gaetanars/esphome-portail/hardware/portail-pcb/portail-pcb.kicad_pcb

## KiCad design hardware/portail-pcb/portail-pcb.kicad_pcb (2026-11-11)

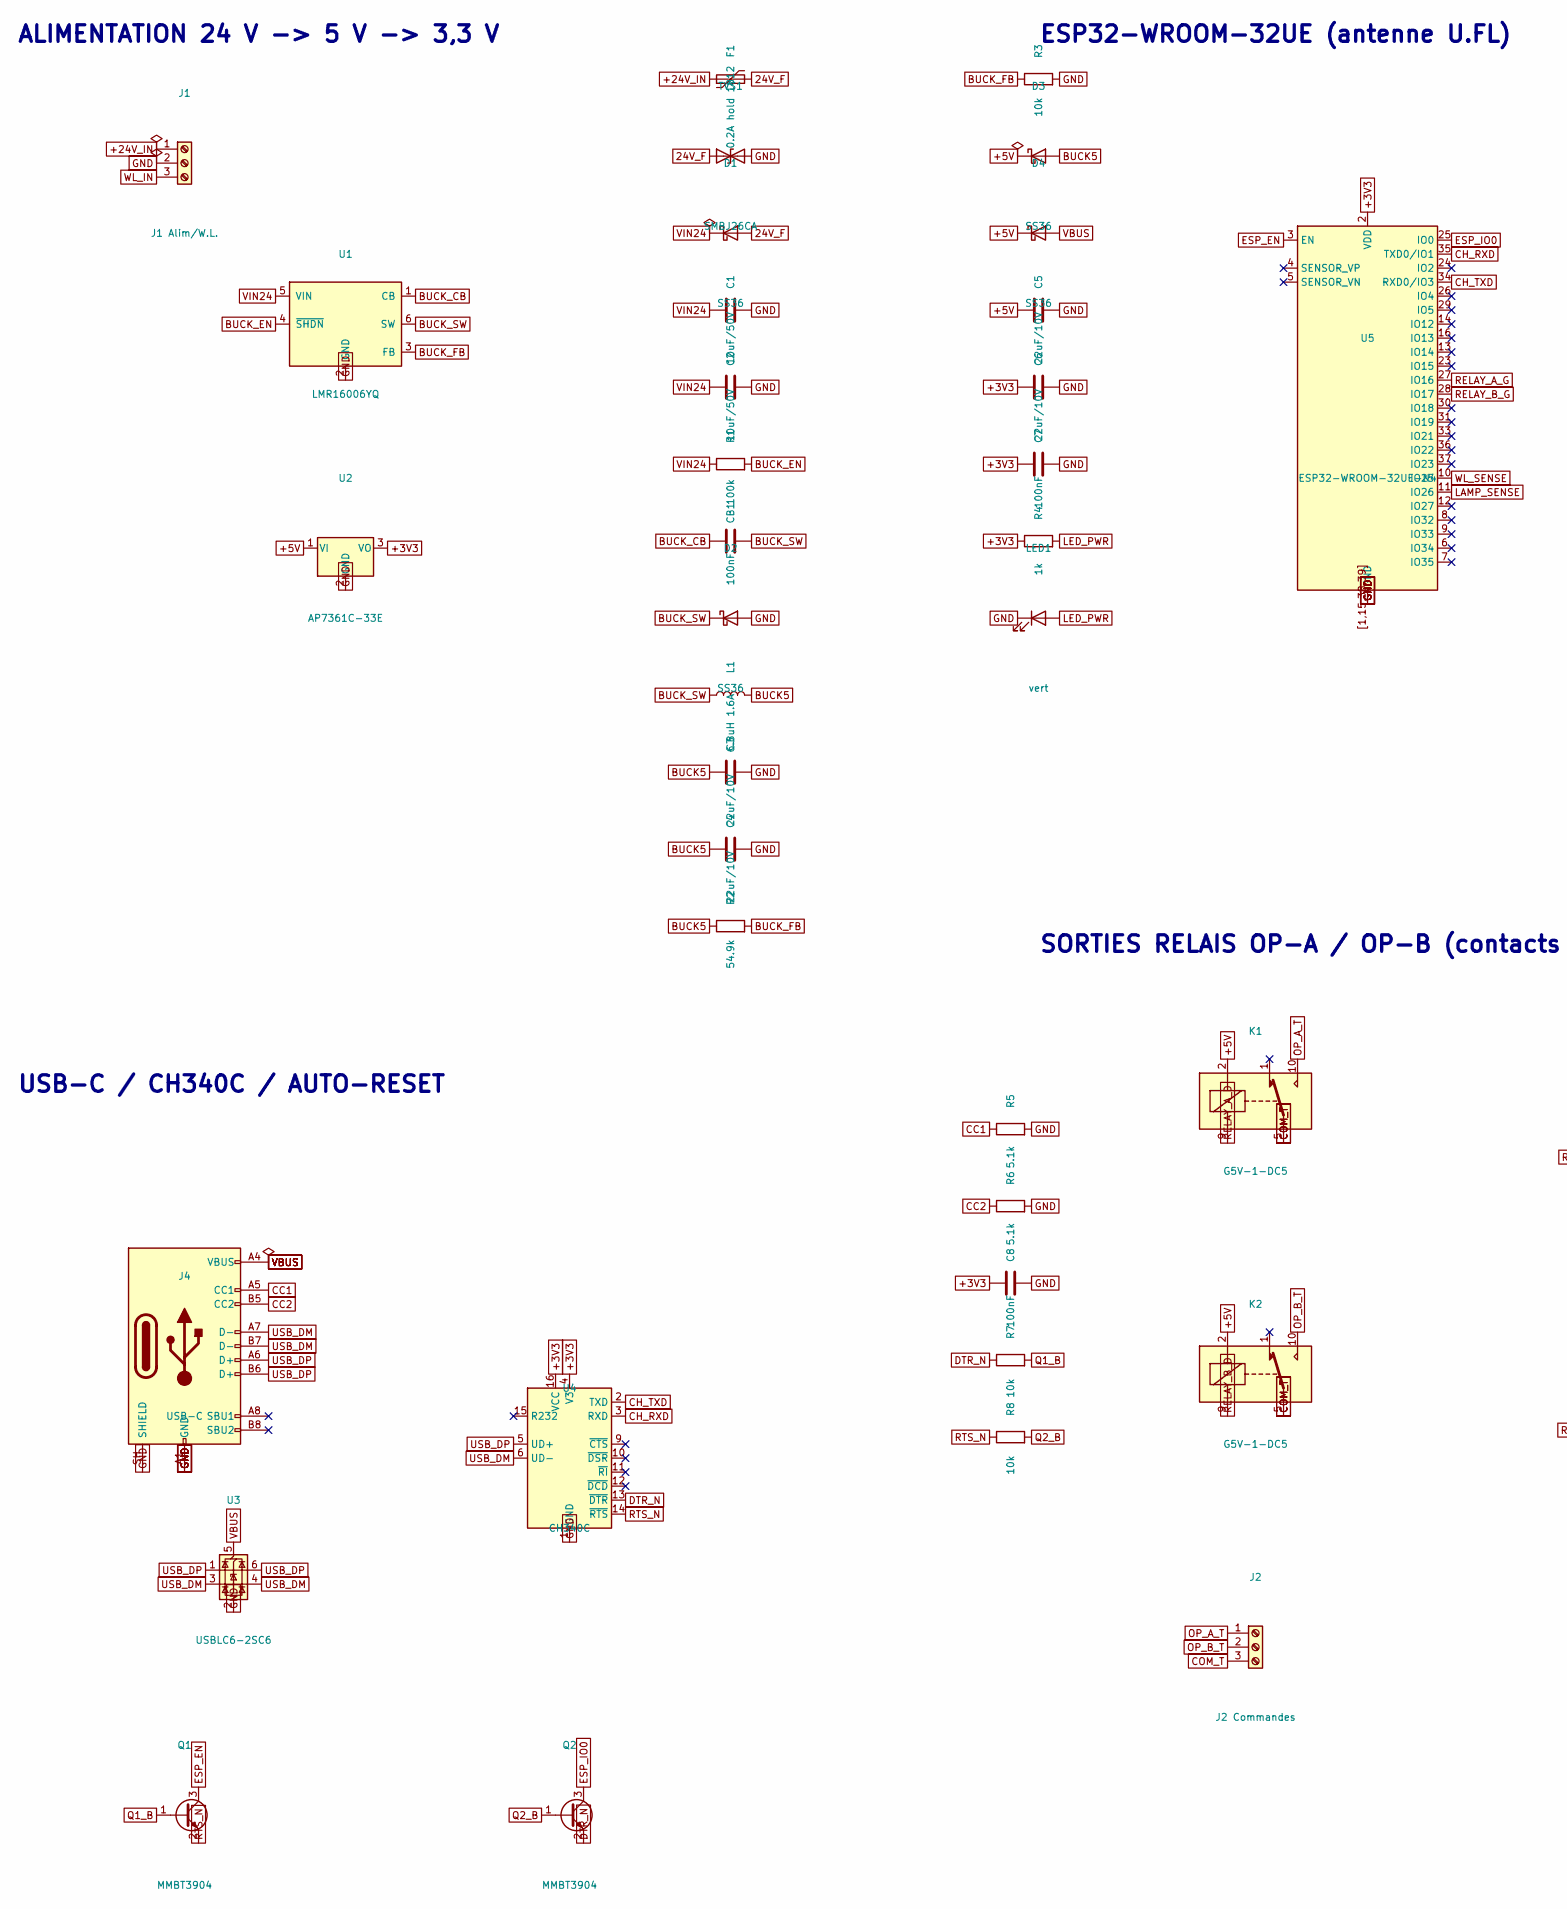
[picture p1: schematic portail-pcb.kicad_sch, Portail FAAC E045S - carte ESP32, part in row 1, column 1]

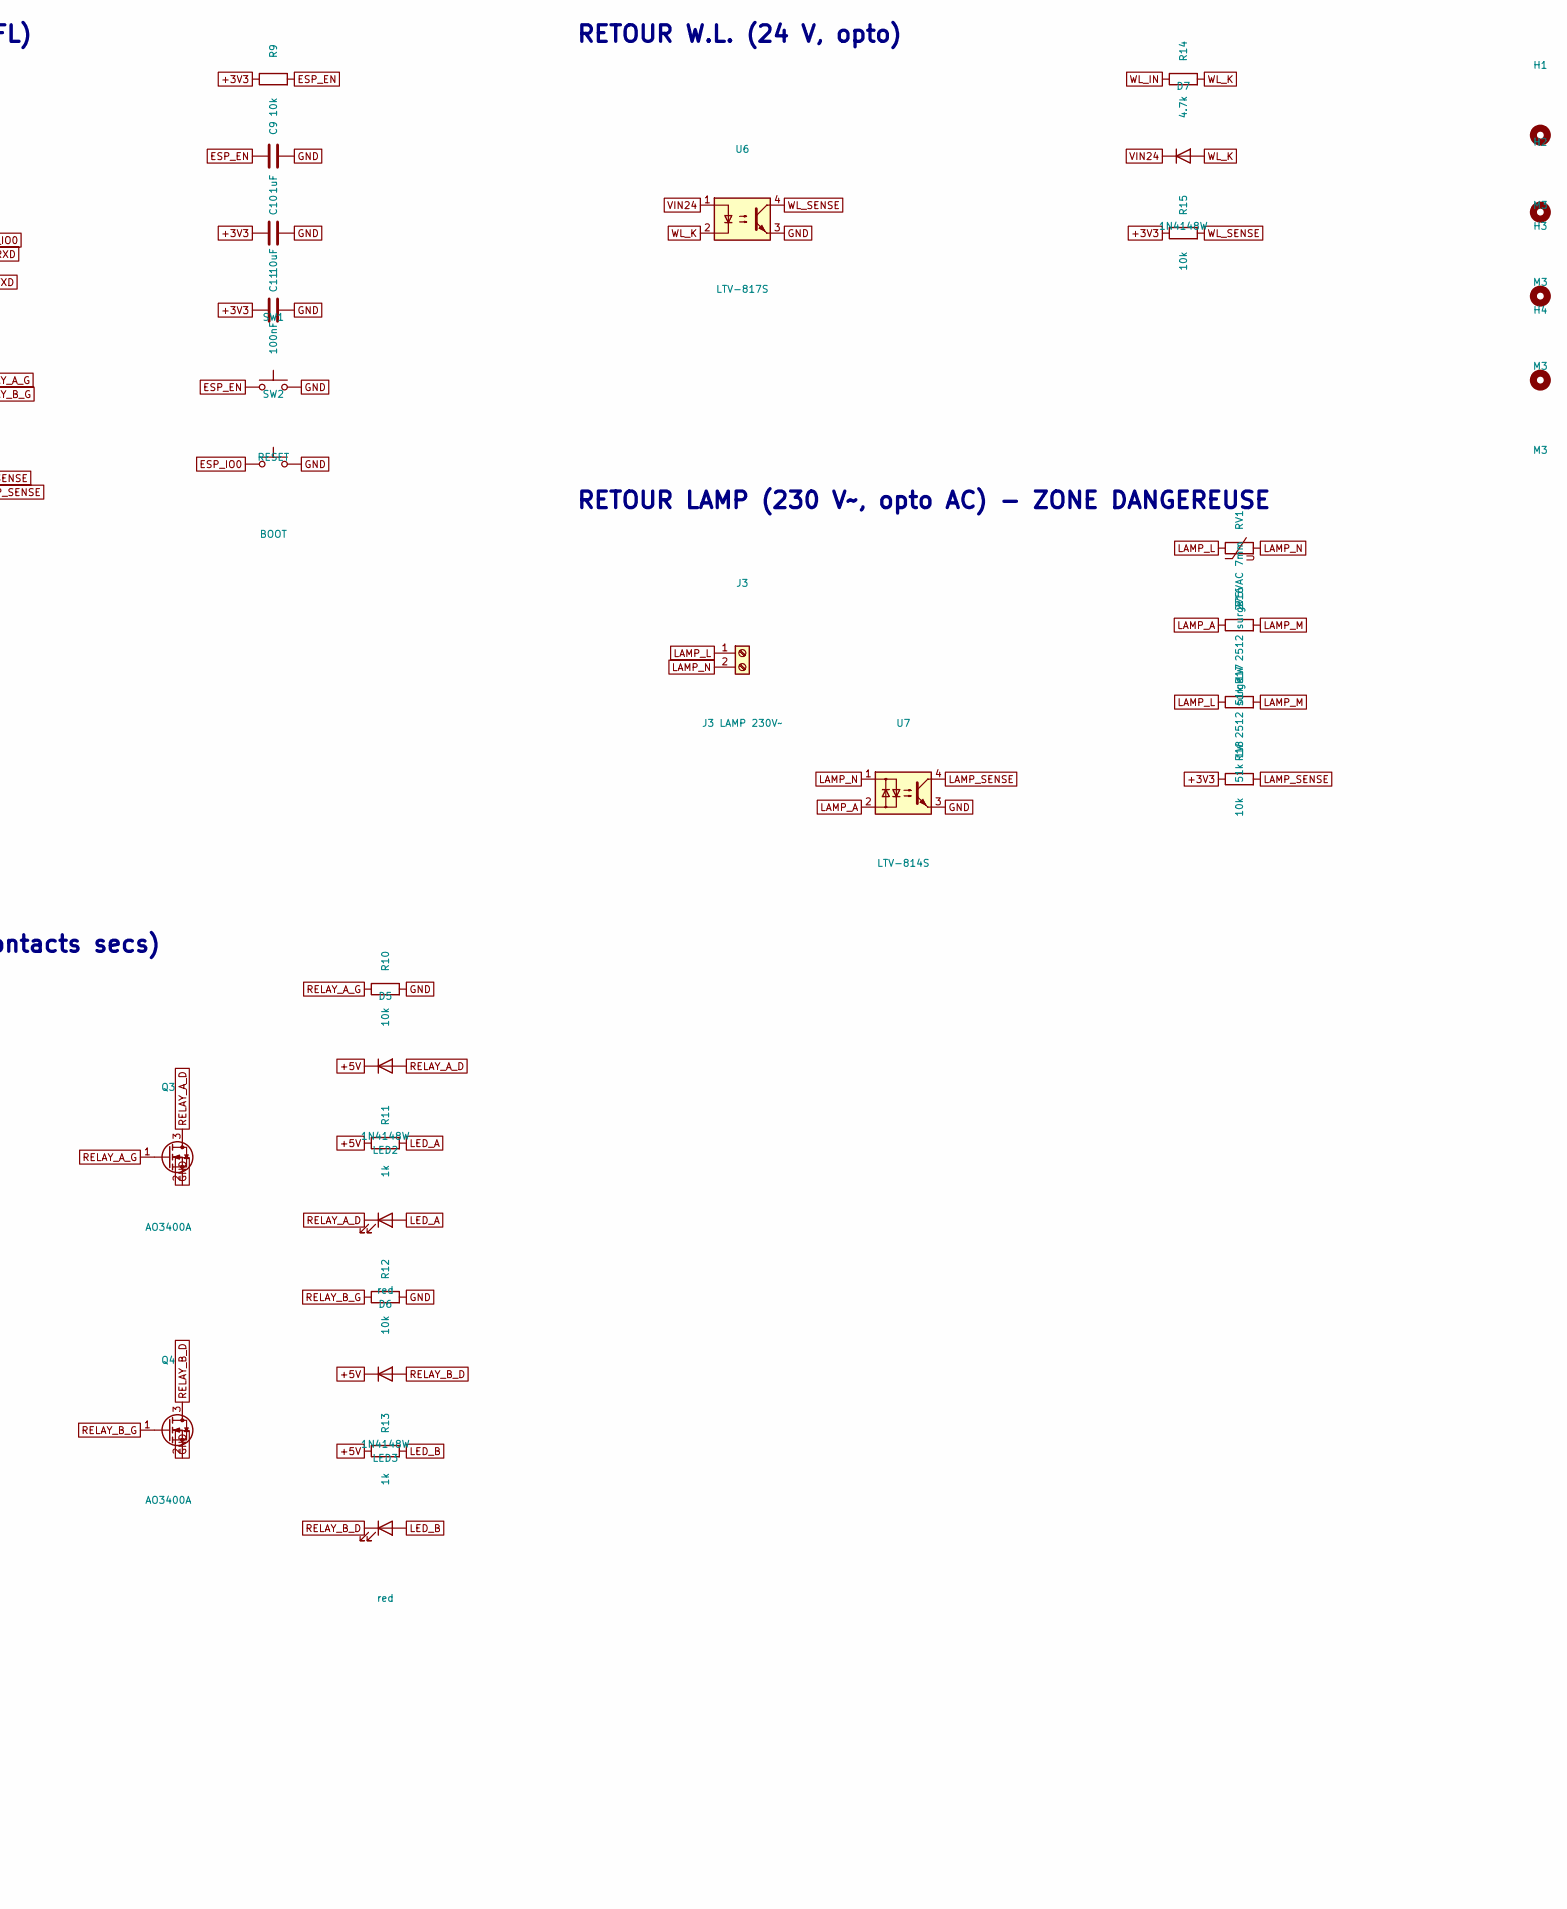
[picture p2: schematic portail-pcb.kicad_sch, Portail FAAC E045S - carte ESP32, part in row 1, column 2]

Parts:
C1, C2: 10uF/50V; C_1210_3225Metric; MPN GRM32ER71H106KA12L
C3, C4, C5, C6: 22uF/10V; C_0805_2012Metric; MPN CL21A226MPQNNNE
C7, C8, C11: 100nF; C_0603_1608Metric; MPN CC0603KRX7R9BB104
C9: 1uF; C_0603_1608Metric; MPN CL10B105KA8NNNC
C10: 10uF; C_0805_2012Metric; MPN CL21A106KAYNNNE
CB1: 100nF; C_0603_1608Metric; MPN CC0603KRX7R9BB104
D1, D2, D3, D4: SS36; D_SMA; MPN SS36
D5, D6, D7: 1N4148W; D_SOD-123; MPN 1N4148W-7-F
F1: 0.2A hold 1812; Fuse_1812_4532Metric; MPN MF-MSMF020/60-2
H1, H2, H3, H4: M3; MountingHole_3.2mm_M3
J1: J1 Alim/W.L.; TerminalBlock_Phoenix_MKDS-1,5-3-5.08_1x03_P5.08mm_Horizont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; MPN DG500-5.08-03P-14-00A(H)
J2: J2 Commandes; TerminalBlock_Phoenix_MKDS-1,5-3-5.08_1x03_P5.08mm_Horizont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; MPN DG500-5.08-03P-14-00A(H)
J3: J3 LAMP 230V~; TerminalBlock_Phoenix_MKDS-1,5-2-5.08_1x02_P5.08mm_Horizont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; MPN DG500-5.08-02P-14-00A(H)
J4: USB-C; USB_C_Receptacle_HRO_TYPE-C-31-M-12; MPN TYPE-C-31-M-12
K1, K2: G5V-1-DC5; Relay_SPDT_Omron_G5V-1; MPN G5V-1-DC5
L1: 6.8uH 1.6A; L_Bourns_SRN6045TA; MPN SRN6045TA-6R8M
LED1: vert; LED_0603_1608Metric; MPN KT-0603G
LED2, LED3: red; LED_0603_1608Metric; MPN KT-0603R
Q1, Q2: MMBT3904; SOT-23; MPN MMBT3904LT1G
Q3, Q4: AO3400A; SOT-23; MPN AO3400A
R1: 100k; R_0603_1608Metric; MPN RC0603FR-07100KL
R2: 54.9k; R_0603_1608Metric; MPN RC0603FR-0754K9L
R3, R7, R8, R9, R10, R12, R15, R18: 10k; R_0603_1608Metric; MPN RC0603FR-0710KL
R4, R11, R13: 1k; R_0603_1608Metric; MPN RC0603FR-071KL
R5, R6: 5.1k; R_0603_1608Metric; MPN RC0603FR-075K1L
R14: 4.7k; R_0603_1608Metric; MPN RC0603FR-074K7L
R16, R17: 51k 1W 2512 surge; R_2512_6332Metric; MPN SR2512MK-0751KL
RV1: 275VAC 7mm; RV_Disc_D7mm_W3.4mm_P5mm; MPN V275LA4P
SW1: RESET; SW_SPST_TL3342; MPN TS-1187A-B-A-B
SW2: BOOT; SW_SPST_TL3342; MPN TS-1187A-B-A-B
TVS1: SMBJ26CA; D_SMB; MPN SMBJ26CA
U1: LMR16006YQ; SOT-23-6; MPN LMR16006YQDDCRQ1
U2: AP7361C-33E; SOT-223-3_TabPin2; MPN AP7361C-33E-13
U3: USBLC6-2SC6; SOT-23-6; MPN USBLC6-2SC6
U4: CH340C; SOIC-16_3.9x9.9mm_P1.27mm; MPN CH340C
U5: ESP32-WROOM-32UE-N4; ESP32-WROOM-32UE; MPN ESP32-WROOM-32UE-N4
U6: LTV-817S; SMDIP-4_W9.53mm; MPN LTV-817S-TA1
U7: LTV-814S; SMDIP-4_W9.53mm; MPN LTV-814S-TA1

Connections:
24V_F: D1.2 (A), F1.2, TVS1.1 (A1)
+3V3: C6.1, C7.1, C8.1, C10.1, C11.1, R4.1, R9.1, R15.1, R18.1, U2.3 (VO), U4.4 (V3), U4.16 (VCC), U5.2 (VDD)
+5V: C5.1, D3.1 (K), D4.1 (K), D5.1 (K), D6.1 (K), K1.2, K2.2, R11.1, R13.1, U2.1 (VI)
+24V_IN: F1.1, J1.1
BUCK5: C3.1, C4.1, D3.2 (A), L1.2, R2.1
BUCK_CB: CB1.1, U1.1 (CB)
BUCK_EN: R1.2, U1.4 (~SHDN)
BUCK_FB: R2.2, R3.1, U1.3 (FB)
BUCK_SW: CB1.2, D2.1 (K), L1.1, U1.6 (SW)
CC1: J4.A5 (CC1), R5.1
CC2: J4.B5 (CC2), R6.1
CH_RXD: U4.3 (RXD), U5.35 (TXD0/IO1)
CH_TXD: U4.2 (TXD), U5.34 (RXD0/IO3)
COM_T: J2.3, K1.5, K1.6, K2.5, K2.6
DTR_N: Q2.2 (E), R7.1, U4.13 (~DTR)
ESP_EN: C9.1, Q1.3 (C), R9.2, SW1.1, U5.3 (EN)
ESP_IO0: Q2.3 (C), SW2.1, U5.25 (IO0)
GND: C1.2, C2.2, C3.2, C4.2, C5.2, C6.2, C7.2, C8.2, C9.2, C10.2, C11.2, D2.2 (A), J1.2, J4.A1 (GND), J4.A12 (GND), J4.B1 (GND), J4.B12 (GND), J4.SH (SHIELD), LED1.1 (K), Q3.2 (S), Q4.2 (S), R3.2, R5.2, R6.2, R10.2, R12.2, SW1.2, SW2.2, TVS1.2 (A2), U1.2 (GND), U2.2 (GND), U3.2 (GND), U4.1 (GND), U5.1, U5.15, U5.38, U5.39, U5.[1,15,38,39] (GND), U6.3, U7.3
LAMP_A: R16.1, U7.2
LAMP_L: J3.1, R17.1, RV1.1
LAMP_M: R16.2, R17.2
LAMP_N: J3.2, RV1.2, U7.1
LAMP_SENSE: R18.2, U5.11 (IO26), U7.4
LED_A: LED2.2 (A), R11.2
LED_B: LED3.2 (A), R13.2
LED_PWR: LED1.2 (A), R4.2
OP_A_T: J2.1, K1.10
OP_B_T: J2.2, K2.10
Q1_B: Q1.1 (B), R7.2
Q2_B: Q2.1 (B), R8.2
RELAY_A_D: D5.2 (A), K1.9, LED2.1 (K), Q3.3 (D)
RELAY_A_G: Q3.1 (G), R10.1, U5.27 (IO16)
RELAY_B_D: D6.2 (A), K2.9, LED3.1 (K), Q4.3 (D)
RELAY_B_G: Q4.1 (G), R12.1, U5.28 (IO17)
RTS_N: Q1.2 (E), R8.1, U4.14 (~RTS)
USB_DM: J4.A7 (D-), J4.B7 (D-), U3.3 (I/O2), U3.4 (I/O2), U4.6 (UD-)
USB_DP: J4.A6 (D+), J4.B6 (D+), U3.1 (I/O1), U3.6 (I/O1), U4.5 (UD+)
VBUS: D4.2 (A), J4.A4 (VBUS), J4.A9 (VBUS), J4.B4 (VBUS), J4.B9 (VBUS), U3.5 (VBUS)
VIN24: C1.1, C2.1, D1.1 (K), D7.1 (K), R1.1, U1.5 (VIN), U6.1
WL_IN: J1.3, R14.1
WL_K: D7.2 (A), R14.2, U6.2
WL_SENSE: R15.2, U5.10 (IO25), U6.4

Notes on the sheet:
ALIMENTATION 24 V -> 5 V -> 3,3 V
USB-C / CH340C / AUTO-RESET
ESP32-WROOM-32UE (antenne U.FL)
SORTIES RELAIS OP-A / OP-B (contacts secs)
RETOUR W.L. (24 V, opto)
RETOUR LAMP (230 V~, opto AC) - ZONE DANGEREUSE

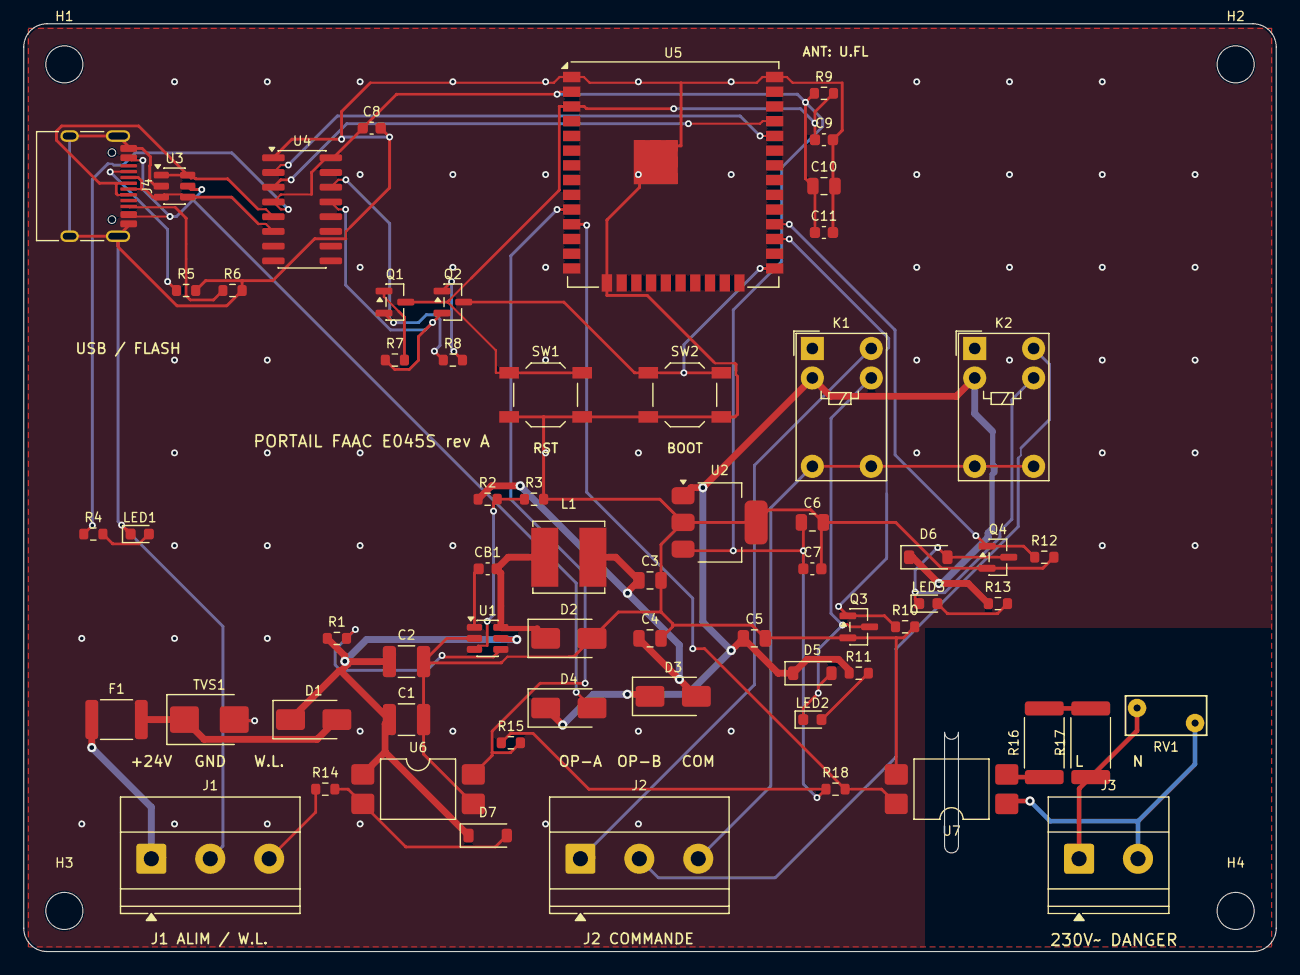
[picture p3: board portail-pcb.kicad_pcb from above]

Board: 2 copper layers, 108.0 x 80.0 mm, 67 parts (0 on the bottom side), 42 nets.
