gaetanars/esphome-portail/(commit log)

2026-11-11 feat(hardware): add integrated ESP32 PCB for FAAC E045S
    KiCad 10 project generated by scripts (schematic, placement, Freerouting,
    GND zones) with PCBWay export and BOM. Keeps GPIO16/17/25/26 so portail.yaml
    is unchanged.
    [portail-pcb.kicad_pcb, portail-pcb.kicad_sch]
2026-11-11 docs: document dedicated PCB and export workflow
